Helios-Rocket/power-management/common/mtj-889x1-model.step

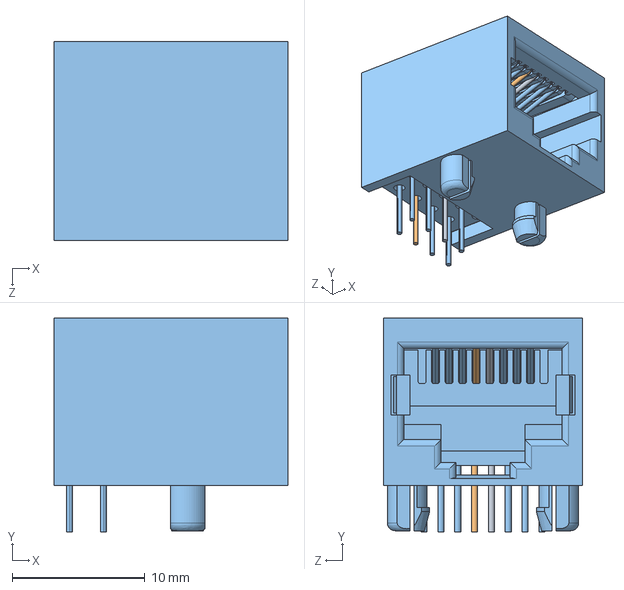
[picture p1: CAD file, 2026-10-05]
common/mtj-889x1-model.step
17.6 x 16.1 x 15.0 mm
