Helios-Rocket/power-management/life-bms/helios-bms-life.step

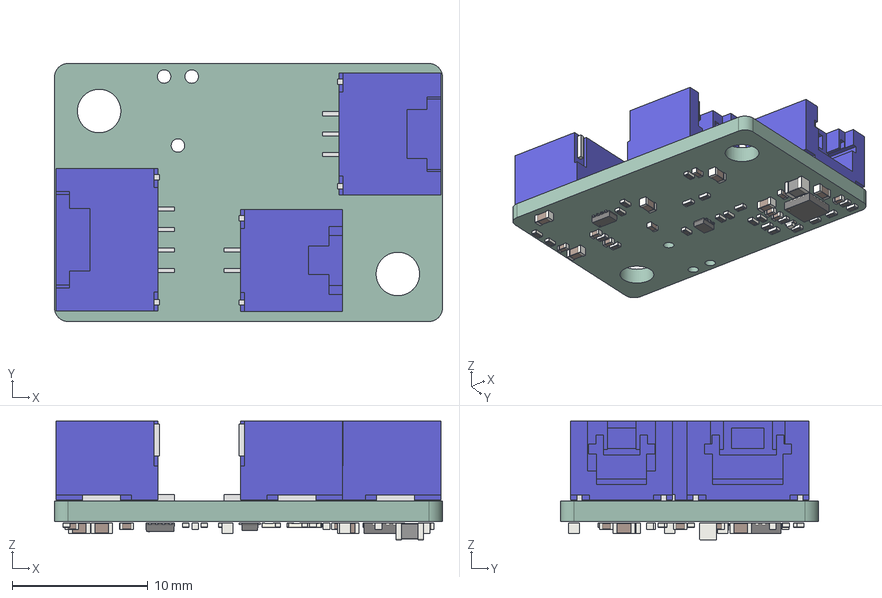
[picture p2: CAD file, 2026-09-29]
life-bms/helios-bms-life.step
28.6 x 19.0 x 8.73 mm
SM04B-ZESS
SM02B-ZESS
SM03B-ZESS
C_0402_1005Metric x 9
SOT_666
R_0402_1005Metric x 23
C_0603_1608Metric x 6
SOT-583-8
WQFN-16-1EP_3x3mm_P0.5mm_EP1.68x1.68mm
LED_0402_1005Metric
L_0805_2012Metric
helios-bms-life-unsaved-export-g4g4PP_PCB
