Helios-Rocket/power-management/lipo-bms/helios-bms-lipo.step

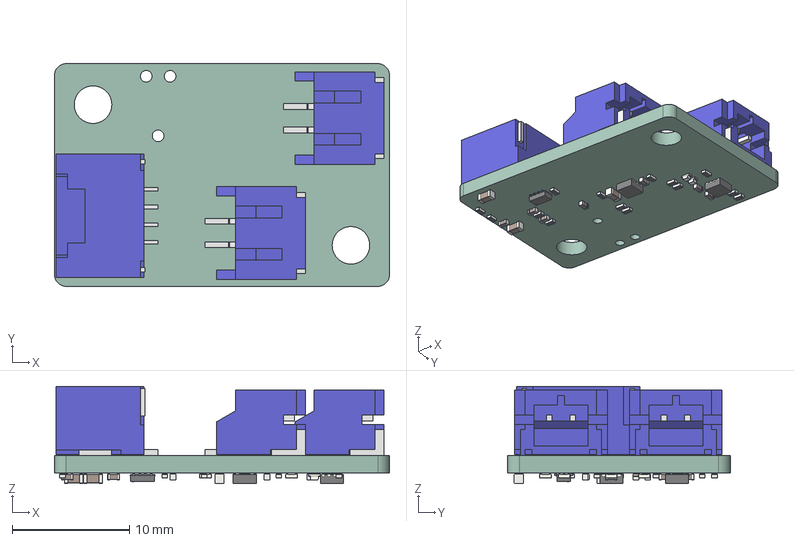
[picture p3: CAD file, 2026-09-29]
lipo-bms/helios-bms-lipo.step
28.6 x 19.0 x 8.30 mm
S2B-PH-SM4 x 2
SM04B-ZESS
C_0402_1005Metric x 7
R_0402_1005Metric x 14
WSON_6_1EP_2x2mm_P065mm_EP1x16mm
SOT-583-8
C_0603_1608Metric x 3
WSON_8_1EP_2x2mm_P05mm_EP09x16mm
LED_0402_1005Metric x 2
helios-bms-lipo-unsaved-export-QEK3tJ_PCB
