Helios-Rocket/power-management/common/2601-1102.igs

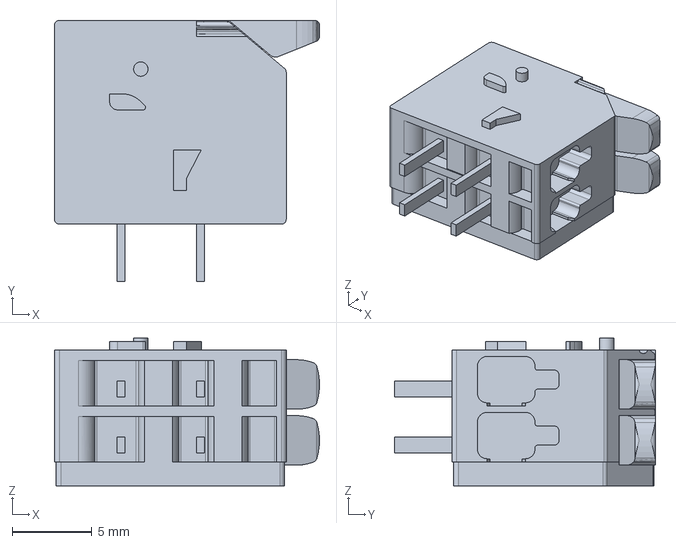
[picture p4: CAD file, 2026-10-05]
common/2601-1102.igs
16.6 x 16.4 x 9.25 mm
