Helios-Rocket/power-management/common/S2B-PH-SM4-TB.STEP

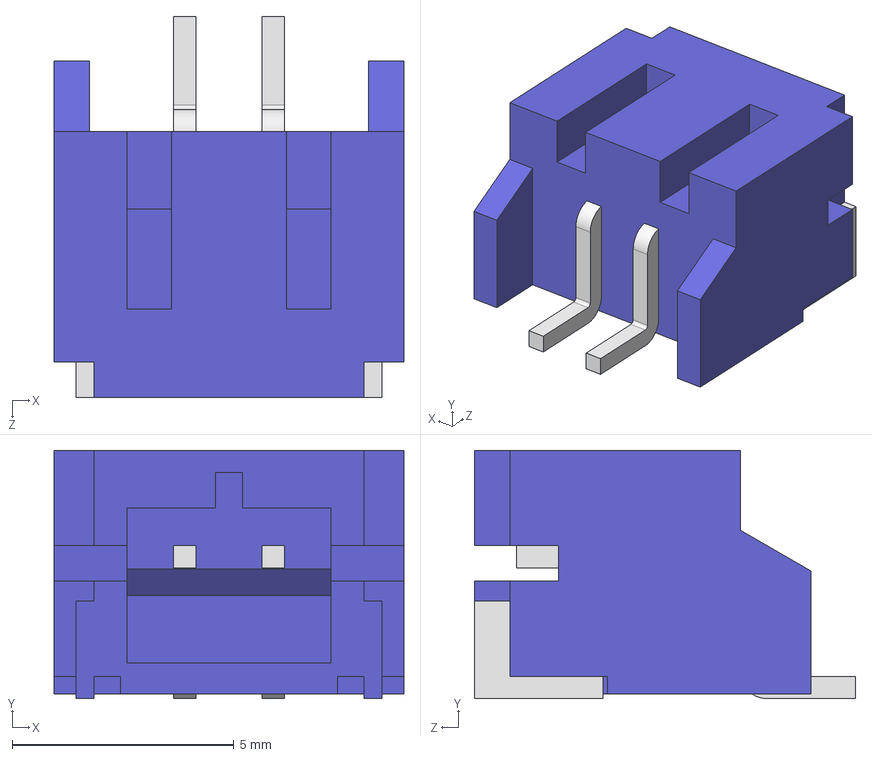
[picture p6: CAD file, 2026-09-29]
common/S2B-PH-SM4-TB.STEP
7.90 x 5.60 x 8.60 mm
