Helios-Rocket/power-management/common/SM02B-ZESS-TB.STEP

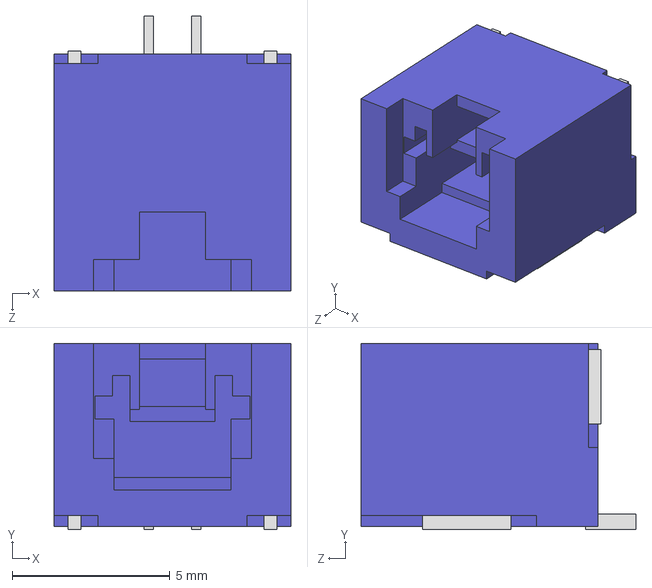
[picture p7: CAD file, 2026-09-29]
common/SM02B-ZESS-TB.STEP
7.50 x 5.90 x 8.70 mm
