Helios-Rocket/power-management/common/SM03B-ZESS-TB.STEP

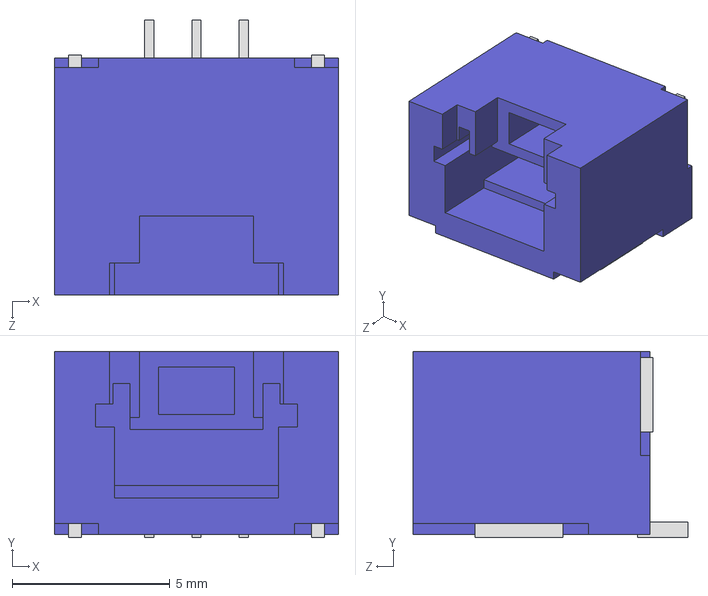
[picture p8: CAD file, 2026-08-21]
common/SM03B-ZESS-TB.STEP
9.00 x 5.90 x 8.70 mm
