Helios-Rocket/power-management/common/UFQFPN20_3x3x0p6.step

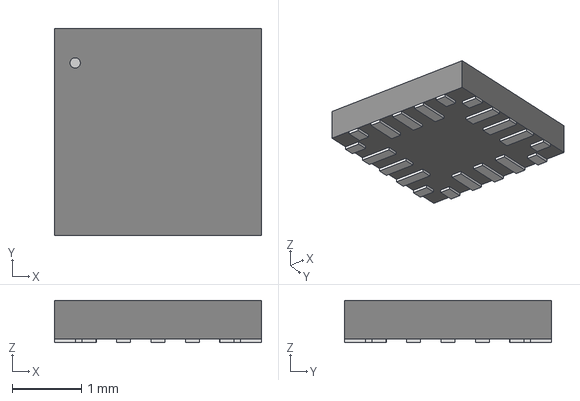
[picture p9: CAD file, 2026-08-21]
common/UFQFPN20_3x3x0p6.step
3.00 x 3.00 x 0.612 mm
