Helios-Rocket/power-management/common/SM04B-ZESS-TB.STEP

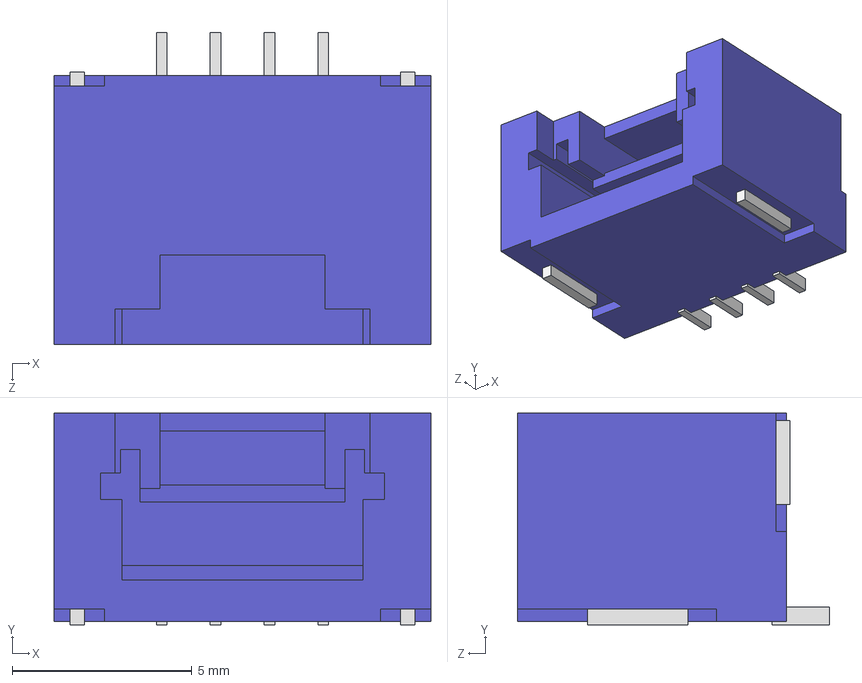
[picture p10: CAD file, 2026-08-21]
common/SM04B-ZESS-TB.STEP
10.5 x 5.90 x 8.70 mm
