Helios-Rocket/power-management/common/UDFN6B.STEP

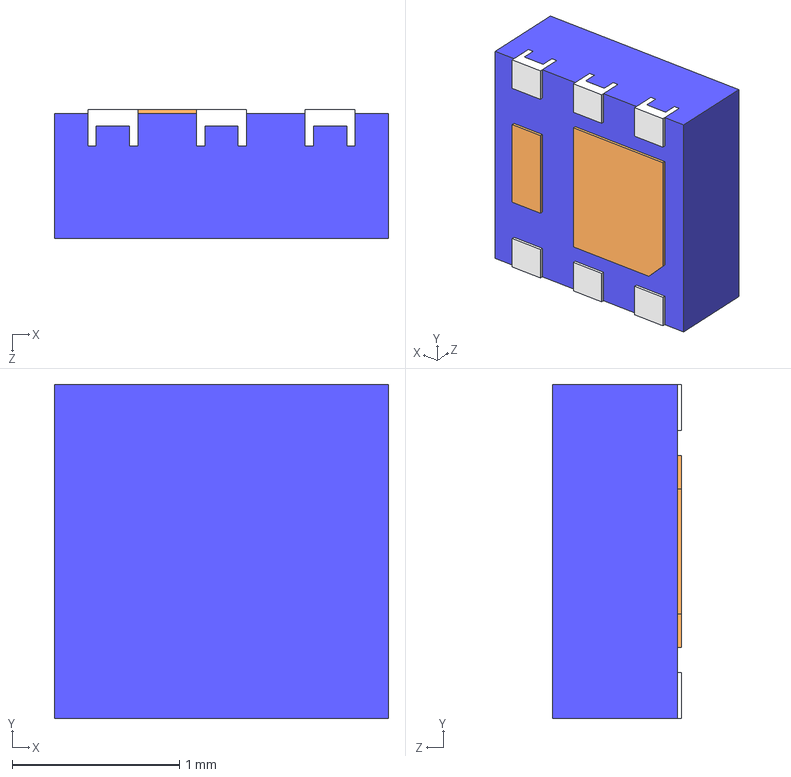
[picture p11: CAD file, 2026-08-18]
common/UDFN6B.STEP
2.00 x 2.00 x 0.775 mm
