Helios-Rocket/power-management/common/TPSM861253RDXR.step

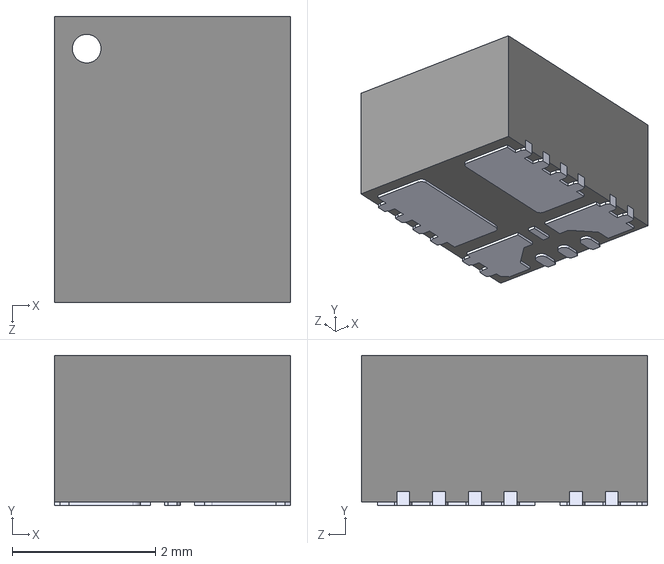
[picture p12: CAD file, 2026-08-14]
common/TPSM861253RDXR.step
3.30 x 2.10 x 4.00 mm
