Helios-Rocket/power-management/common/TPS22811LRPWR.STEP

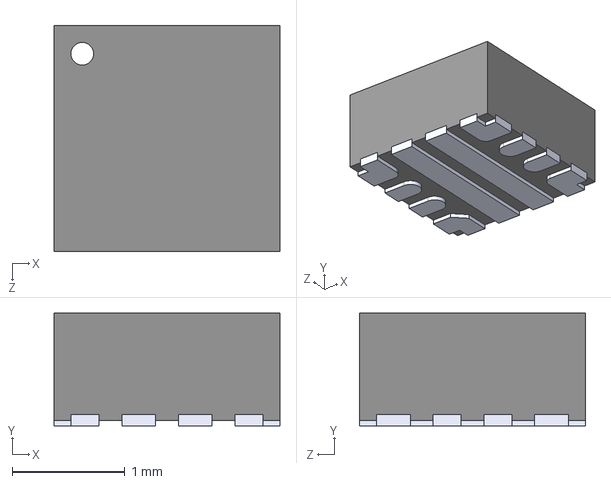
[picture p13: CAD file, 2026-08-07]
common/TPS22811LRPWR.STEP
2.00 x 1.00 x 2.00 mm
