Helios-Rocket/power-management/vehicle-connector/vehicle-connector.kicad_pcb

## KiCad design vehicle-connector/vehicle-connector.kicad_pcb (2026-10-07)

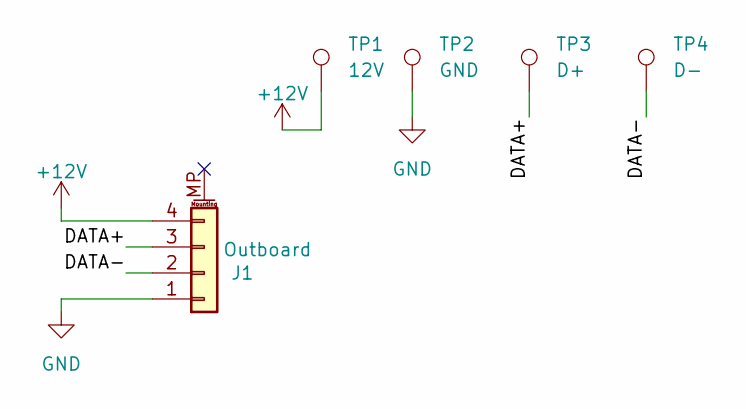
[picture p14: schematic vehicle-connector.kicad_sch]

Parts:
J1: Outboard; JST_ZE_SM04B-ZESS-TB_1x04-1MP_P1.50mm_Horizontal
TP1: 12V; TestPoint_Pad_4.0x4.0mm
TP2: GND; TestPoint_Pad_4.0x4.0mm
TP3: D+; TestPoint_Pad_4.0x4.0mm
TP4: D-; TestPoint_Pad_4.0x4.0mm

Connections:
+12V: J1.4, TP1.1 (1_1)
/DATA+: J1.3, TP3.1 (1_1)
/DATA-: J1.2, TP4.1 (1_1)
GND: J1.1, TP2.1 (1_1)

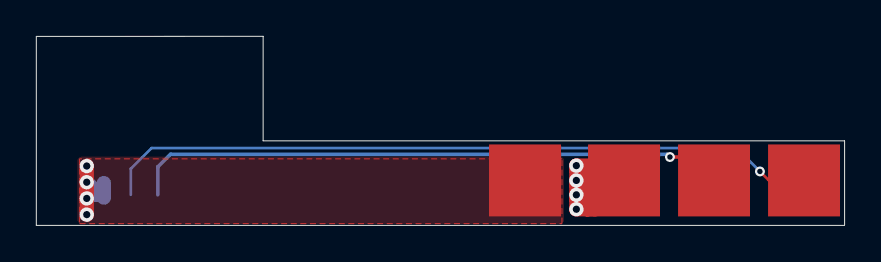
[picture p15: board vehicle-connector.kicad_pcb from above]

Board: 2 copper layers, 44.9 x 10.5 mm, 5 parts (1 on the bottom side), 4 nets.
