Helios-Rocket/power-management/life-bms/helios-bms-life.kicad_pcb

## KiCad design life-bms/helios-bms-life.kicad_pcb (2026-10-07)

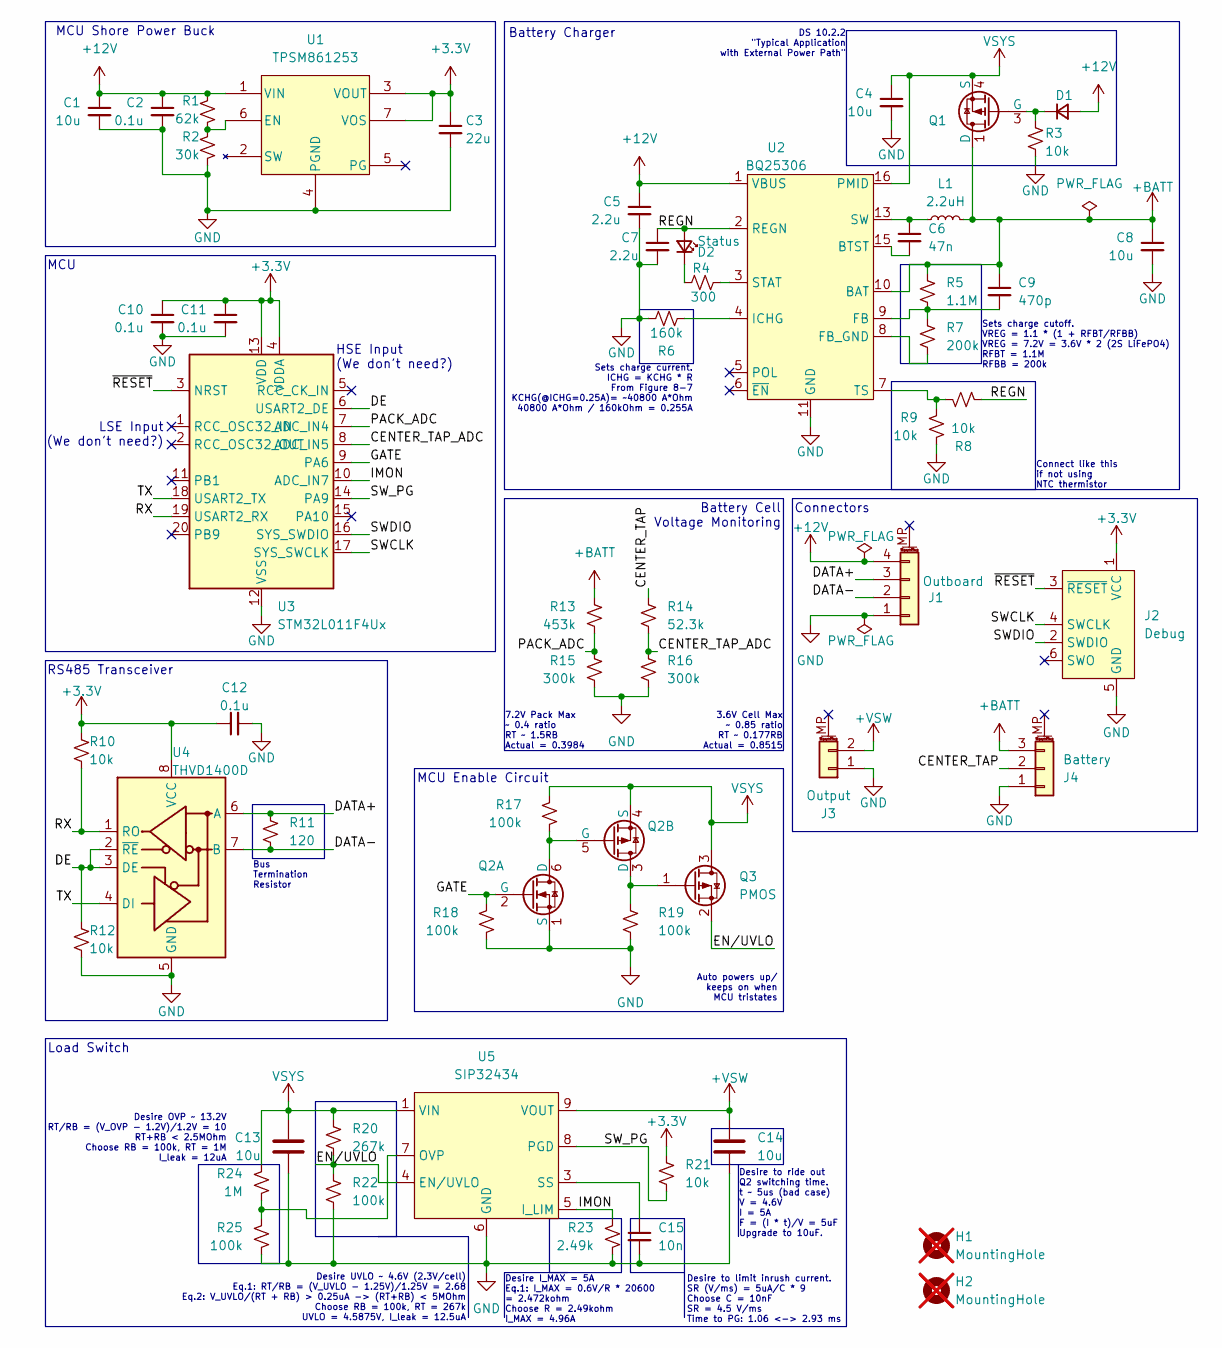
[picture p16: schematic helios-bms-life.kicad_sch]

Parts:
C1, C4, C8, C13, C14: 10u; C_0603_1608Metric
C2, C10, C11, C12: 0.1u; C_0402_1005Metric
C3: 22u; C_0603_1608Metric
C5, C7: 2.2u; C_0402_1005Metric
C6: 47n; C_0402_1005Metric
C9: 470p; C_0402_1005Metric
C15: 10n; C_0402_1005Metric
D1: GSDH3005; D_0402_1005Metric
D2: Status; LED_0402_1005Metric
H1, H2: MountingHole; MountingHole_3.2mm_M3_DIN965; not fitted
J1: Outboard; JST_ZE_SM04B-ZESS-TB_1x04-1MP_P1.50mm_Horizontal
J2: Debug; Tag-Connect_TC2030-IDC-NL_2x03_P1.27mm_Vertical
J3: Output; JST_ZE_SM02B-ZESS-TB_1x02-1MP_P1.50mm_Horizontal
J4: Battery; JST_ZE_SM03B-ZESS-TB_1x03-1MP_P1.50mm_Horizontal
L1: 2.2uH; L_0805_2012Metric
Q1: SSM6J507NU; SOT-1220_UDFN6B_TOS-L
Q2: Q_Dual_NMOS_PMOS_S1G1D2S2G2D1; SOT-666
Q3: PMOS; SOT-723
R1: 62k; R_0402_1005Metric
R2: 30k; R_0402_1005Metric
R3, R8, R9, R10, R12, R21: 10k; R_0402_1005Metric
R4: 300; R_0402_1005Metric
R5: 1.1M; R_0402_1005Metric
R6: 160k; R_0402_1005Metric
R7: 200k; R_0402_1005Metric
R11: 120; R_0402_1005Metric
R13: 453k; R_0402_1005Metric
R14: 52.3k; R_0402_1005Metric
R15, R16: 300k; R_0402_1005Metric
R17, R18, R19, R22, R25: 100k; R_0402_1005Metric
R20: 267k; R_0402_1005Metric
R23: 2.49k; R_0402_1005Metric
R24: 1M; R_0402_1005Metric
U1: TPSM861253; Texas-QFN-FCMOD-7_4x3.3mm
U2: BQ25306; WQFN-16-1EP_3x3mm_P0.5mm_EP1.68x1.68mm_ThermalVias
U3: STM32L011F4Ux; ST_UFQFPN-20_3x3mm_P0.5mm
U4: THVD1400D; SOT-583-8
U5: SIP32434; Maxim_TDFN-10-1EP_3x3mm_P0.5mm_EP1.58x2.35mm

Connections:
+3.3V: C3.1, C10.1, C11.1, C12.1, J2.1 (VCC), R10.1, R21.2, U1.3 (VOUT), U1.7 (VOS), U3.4 (VDDA), U3.13 (VDD), U4.8 (VCC)
+12V: C1.1, C2.1, C5.1, D1.2 (A), J1.4, R1.1, U1.1 (VIN), U2.1 (VBUS)
+BATT: C8.1, C9.1, J4.3, L1.2, Q1.1 (D), Q1.2 (D), Q1.5 (D), Q1.6 (D), Q1.7 (D), R5.1, R13.1, U2.10 (BAT)
+VSW: C14.1, J3.2, U5.9 (VOUT), U5.10 (VOUT)
/CENTER_TAP: J4.2, R14.1
/CENTER_TAP_ADC: R14.2, R16.1, U3.8 (ADC_IN5)
/DATA+: J1.3, R11.1, U4.6 (A)
/DATA-: J1.2, R11.2, U4.7 (B)
/DE: R12.1, U3.6 (USART2_DE), U4.2 (~RE), U4.3 (DE)
/EN/UVLO: Q3.2 (S), R20.1, R22.2, U5.4 (EN/UVLO)
/GATE: Q2.2 (G), R18.1, U3.9 (PA6)
/IMON: R23.2, U3.10 (ADC_IN7), U5.5 (I_LIM)
/PACK_ADC: R13.2, R15.1, U3.7 (ADC_IN4)
/REGN: C7.1, D2.2 (A), R8.2, U2.2 (REGN)
/RX: R10.2, U3.19 (USART2_RX), U4.1 (RO)
/SWCLK: J2.4 (SWCLK), U3.17 (SYS_SWCLK)
/SWDIO: J2.2 (SWDIO), U3.16 (SYS_SWDIO)
/SW_PG: R21.1, U3.14 (PA9), U5.8 (PGD)
/TX: U3.18 (USART2_TX), U4.4 (DI)
/~RESET: J2.3 (~RESET), U3.3 (NRST)
GND: C1.2, C2.2, C3.2, C4.2, C5.2, C7.2, C8.2, C10.2, C11.2, C12.2, C13.2, C14.2, C15.2, J1.1, J2.5 (GND), J3.1, J4.1, Q2.1 (S), R2.2, R3.2, R6.2, R9.2, R12.2, R15.2, R16.2, R18.2, R19.2, R22.1, R23.1, R25.1, U1.4 (PGND), U2.11 (GND), U2.12 (GND), U2.17 (GND), U3.12 (VSS), U4.5 (GND), U5.6 (GND), U5.11 (GND)
unnamed: C6.1, L1.1, U2.13 (SW), U2.14 (SW)
unnamed: D1.1 (K), Q1.3 (G), R3.1
unnamed: D2.1 (K), R4.1
unnamed: Q2.5 (G), Q2.6 (D), R17.2
unnamed: Q2.3 (D), Q3.1 (G), R19.1
unnamed: R1.2, R2.1, U1.6 (EN)
unnamed: C6.2, U2.15 (BTST)
unnamed: C9.2, R5.2, R7.1, U2.9 (FB)
unnamed: R7.2, U2.8 (FB_GND)
unnamed: R6.1, U2.4 (ICHG)
unnamed: R4.2, U2.3 (STAT)
unnamed: R8.1, R9.1, U2.7 (TS)
unnamed: R24.1, R25.2, U5.7 (OVP)
unnamed: C15.1, U5.3 (SS)
VSYS: C4.1, C13.1, Q1.4 (S), Q1.8 (S), Q2.4 (S), Q3.3 (D), R17.1, R20.2, R24.2, U2.16 (PMID), U5.1 (VIN), U5.2 (VIN)

Notes on the sheet:
LSE Input (We don't need?)
MCU Shore Power Buck
Load Switch
DS 10.2.2 "Typical Application with External Power Path"
Sets charge cutoff. VREG = 1.1 * (1 + RFBT/RFBB) VREG = 7.2V = 3.6V * 2 (2S LiFePO4) RFBT = 1.1M RFBB = 200k
Sets charge current. ICHG = KCHG * R From Figure 8-7 KCHG(@ICHG=0.25A)= ~40800 A*Ohm 40800 A*Ohm / 160kOhm = 0.255A
Connect like this if not using NTC thermistor
HSE Input (We don't need?)
RS485 Transceiver
MCU Enable Circuit
Auto powers up/ keeps on when MCU tristates
MCU
Bus Termination Resistor
Desire to limit inrush current. SR (V/ms) = 5uA/C * 9 Choose C = 10nF SR = 4.5 V/ms Time to PG: 1.06 <-> 2.93 ms
Desire UVLO ~ 4.6V (2.3V/cell) Eq.1: RT/RB = (V_UVLO - 1.25V)/1.25V = 2.68 Eq.2: V_UVLO/(RT + RB) > 0.25uA -> (RT+RB) < 5MOhm Choose RB = 100k, RT = 267k UVLO = 4.5875V, I_leak = 12.5uA
Battery Cell Voltage Monitoring
7.2V Pack Max ~ 0.4 ratio RT ~ 1.5RB Actual = 0.3984
Battery Charger
Desire I_MAX = 5A Eq.1: I_MAX = 0.6V/R * 20600 = 2.472kohm Choose R = 2.49kohm I_MAX = 4.96A
Desire OVP ~ 13.2V RT/RB = (V_OVP - 1.2V)/1.2V = 10 RT+RB < 2.5MOhm Choose RB = 100k, RT = 1M I_leak = 12uA
Desire to ride out Q2 switching time. t ~ 5us (bad case) V = 4.6V I = 5A F = (I * t)/V = 5uF Upgrade to 10uF.
3.6V Cell Max ~ 0.85 ratio RT ~ 0.177RB Actual = 0.8515
Connectors

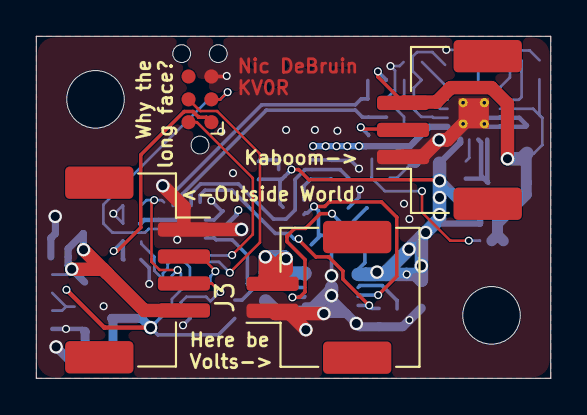
[picture p17: board helios-bms-life.kicad_pcb from above]

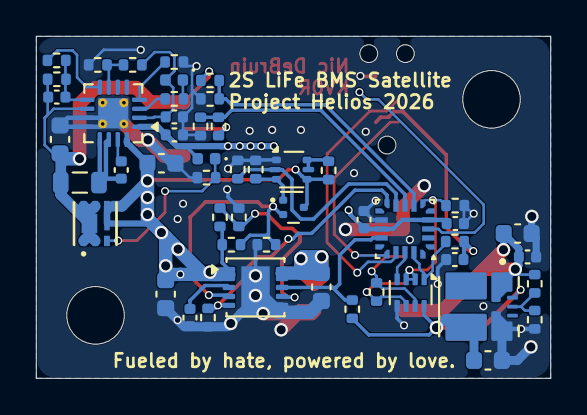
[picture p18: board helios-bms-life.kicad_pcb from below]

Board: 4 copper layers, 28.6 x 19.0 mm, 57 parts (51 on the bottom side), 36 nets.
