Helios-Rocket/power-management/umbilical-controller/umbilical-controller.kicad_pcb

## KiCad design umbilical-controller/umbilical-controller.kicad_pcb (2026-10-07)

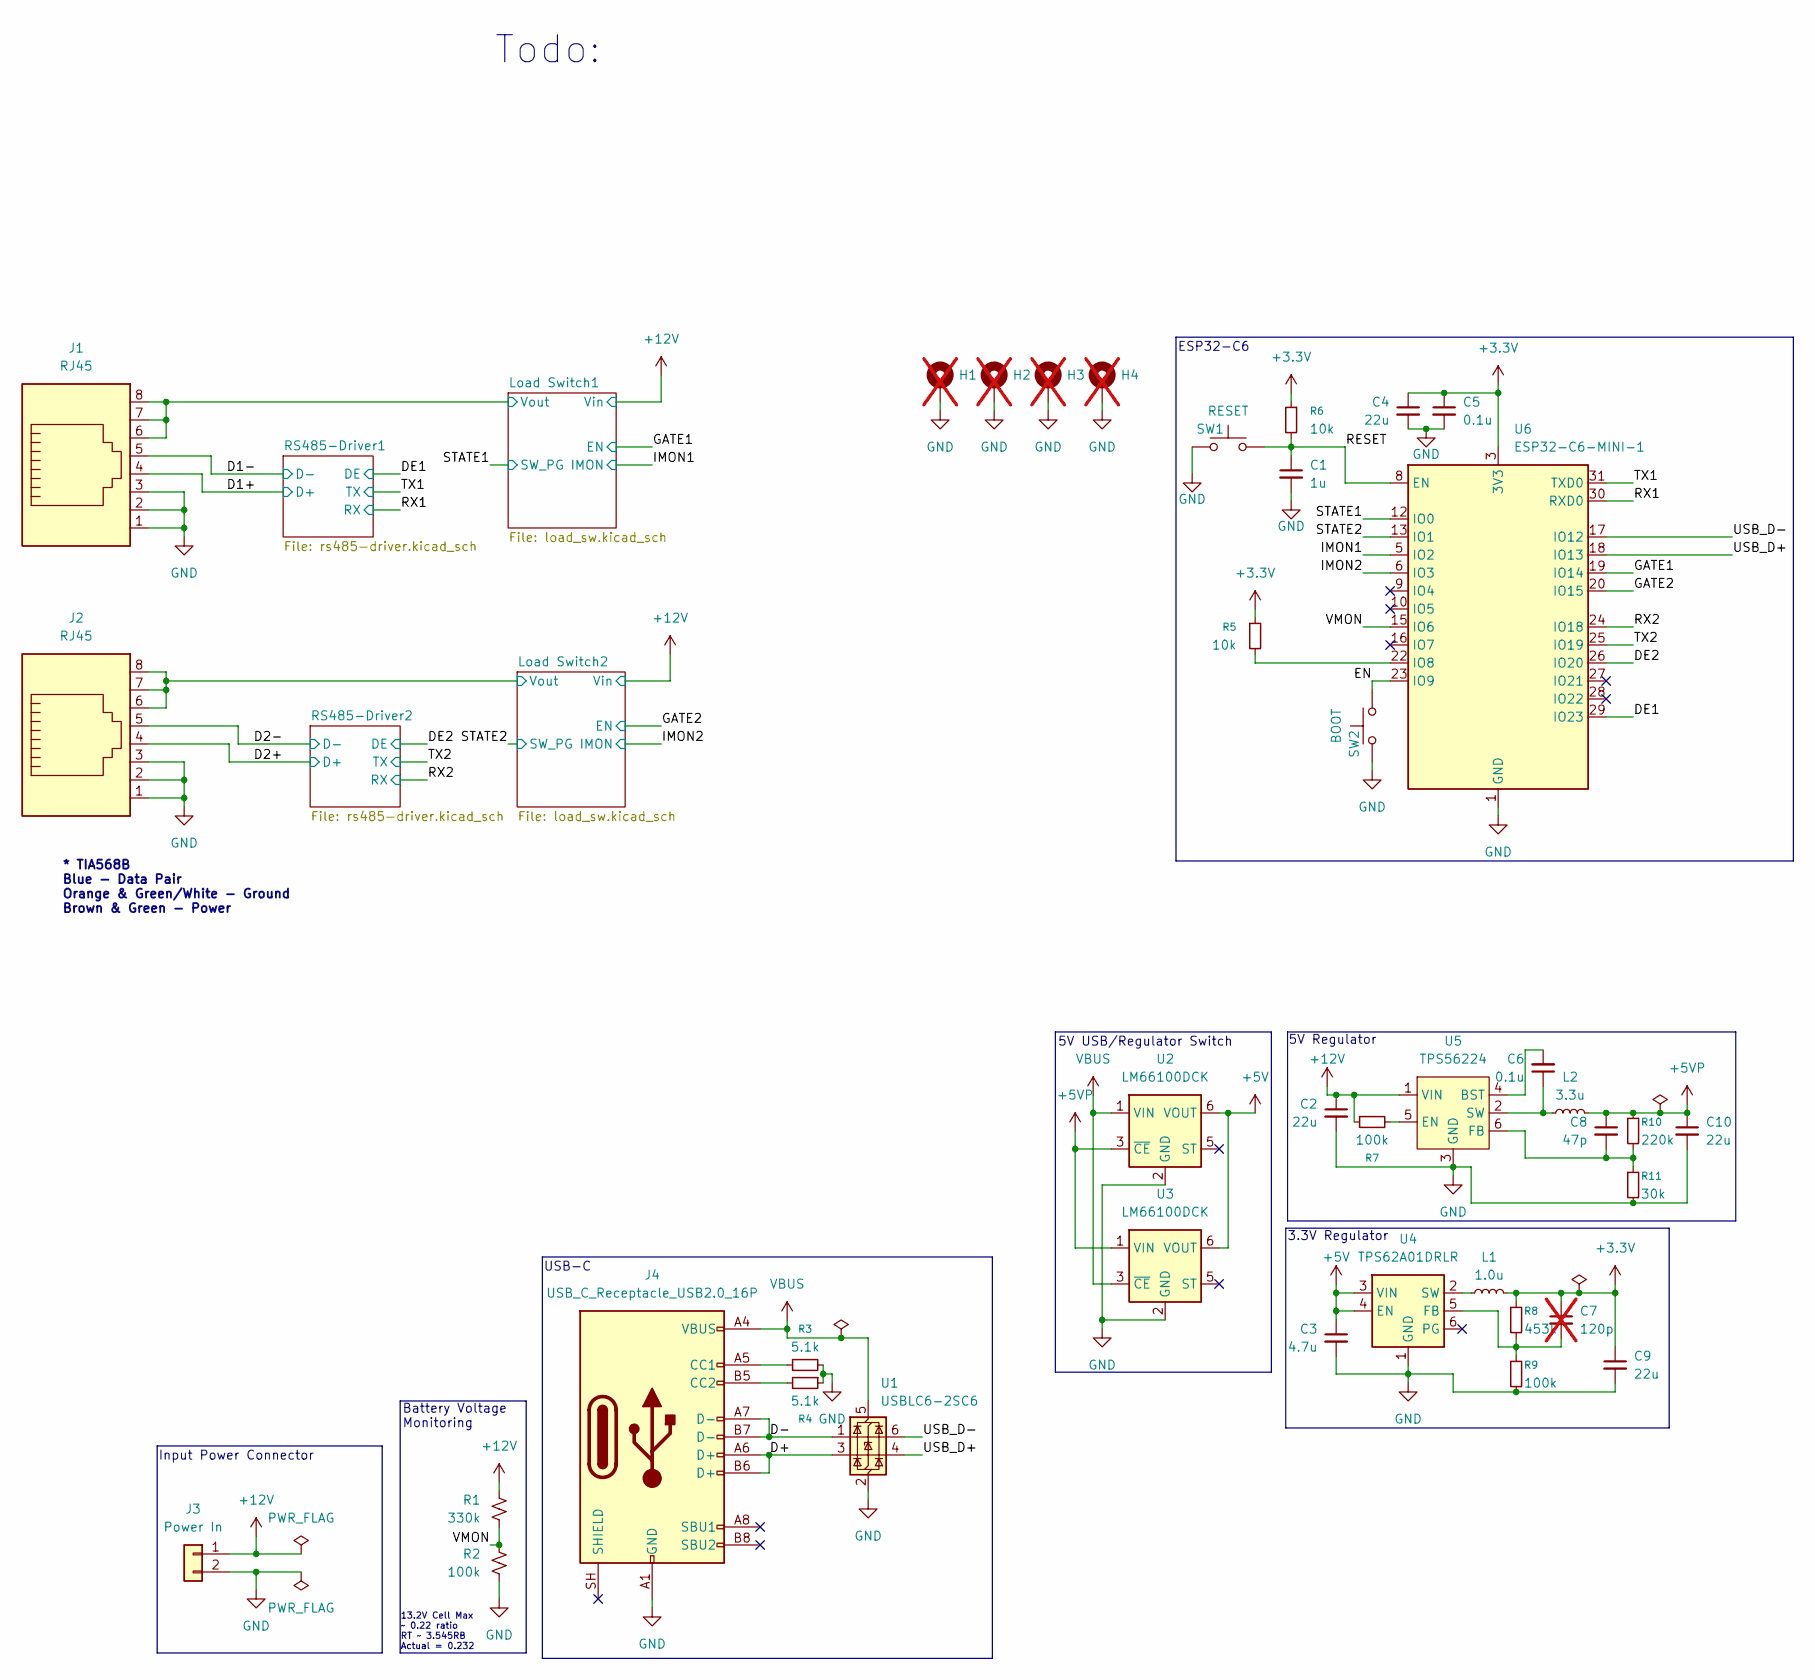
[picture p19: schematic umbilical-controller.kicad_sch]

Parts:
C1: 1u; C_0603_1608Metric
C2: 22u; C_0805_2012Metric
C3: 4.7u; C_0603_1608Metric
C4, C9, C10: 22u; C_0603_1608Metric
C5, C6: 0.1u; C_0603_1608Metric
C7: 120p; C_0603_1608Metric; not fitted
C8: 47p; C_0603_1608Metric
H1, H2, H3, H4: MountingHole_Pad_MP; MountingHole_4.3mm_M4_ISO7380_Pad_TopBottom; not fitted
J1, J2: RJ45; RJ45_Amphenol_54602-x08_Horizontal
J3: Power In; TerminalBlock_WAGO_2601-1102_1x02_P3.50mm_Horizontal
J4: USB_C_Receptacle_USB2.0_16P; USB_C_Receptacle_GCT_USB4105-xx-A_16P_TopMnt_Horizontal
L1: 1.0u; L_1008_2520Metric
L2: 3.3u; L_1008_2520Metric
R1: 330k; R_0603_1608Metric
R2, R7, R9: 100k; R_0603_1608Metric
R3, R4: 5.1k; R_0603_1608Metric
R5, R6: 10k; R_0603_1608Metric
R8: 453k; R_0603_1608Metric
R10: 220k; R_0603_1608Metric
R11: 30k; R_0603_1608Metric
SW1: RESET; SW_Push_1P1T_NO_E-Switch_TL3301NxxxxxG
SW2: BOOT; SW_Push_1P1T_NO_E-Switch_TL3301NxxxxxG
U1: USBLC6-2SC6; SOT-23-6
U2, U3: LM66100DCK; SOT-363_SC-70-6
U4: TPS62A01DRLR; SOT-563
U5: TPS56224; SOT-563
U6: ESP32-C6-MINI-1

Connections:
+3.3V: C4.1, C5.1, C7.1, C9.1, L1.2, R5.1, R6.1, R8.1, U6.3 (3V3); also elsewhere on the board
+5V: C3.1, U2.6 (VOUT), U3.6 (VOUT), U4.3 (VIN), U4.4 (EN)
+5VP: C8.1, C10.1, L2.2, R10.1, U2.3 (~CE), U3.1 (VIN)
+12V: C2.1, J3.1, R1.1, R7.1, U5.1 (VIN); also elsewhere on the board
/D1+: J1.4; also elsewhere on the board
/D1-: J1.5; also elsewhere on the board
/D2+: J2.4; also elsewhere on the board
/D2-: J2.5; also elsewhere on the board
/D+: J4.A6 (D+), J4.B6 (D+), U1.3 (I/O2)
/D-: J4.A7 (D-), J4.B7 (D-), U1.1 (I/O1)
/DE1: U6.29 (IO23); also elsewhere on the board
/DE2: U6.26 (IO20); also elsewhere on the board
/EN: SW2.1, U6.23 (IO9)
/GATE1: U6.19 (IO14); also elsewhere on the board
/GATE2: U6.20 (IO15); also elsewhere on the board
/IMON1: U6.5 (IO2); also elsewhere on the board
/IMON2: U6.6 (IO3); also elsewhere on the board
/Load Switch1/Vout: J1.6, J1.7, J1.8; also elsewhere on the board
/Load Switch2/Vout: J2.6, J2.7, J2.8; also elsewhere on the board
/RESET: C1.1, R6.2, SW1.1, U6.8 (EN)
/RX1: U6.30 (RXD0); also elsewhere on the board
/RX2: U6.24 (IO18); also elsewhere on the board
/STATE1: U6.12 (IO0); also elsewhere on the board
/STATE2: U6.13 (IO1); also elsewhere on the board
/TX1: U6.31 (TXD0); also elsewhere on the board
/TX2: U6.25 (IO19); also elsewhere on the board
/USB_D+: U1.4 (I/O2), U6.18 (IO13)
/USB_D-: U1.6 (I/O1), U6.17 (IO12)
/VMON: R1.2, R2.1, U6.15 (IO6)
GND: C1.2, C2.2, C3.2, C4.2, C5.2, C9.2, C10.2, H1.1 (1_1), H2.1 (1_1), H3.1 (1_1), H4.1 (1_1), J1.1, J1.2, J1.3, J2.1, J2.2, J2.3, J3.2, J4.A1 (GND), J4.A12 (GND), J4.B1 (GND), J4.B12 (GND), R2.2, R3.2, R4.1, R9.2, R11.2, SW1.2, SW2.2, U1.2 (GND), U2.2 (GND), U3.2 (GND), U4.1 (GND), U5.3 (GND), U6.1 (GND), U6.2 (GND), U6.11 (GND), U6.14 (GND), U6.36 (GND), U6.37 (GND), U6.38 (GND), U6.39 (GND), U6.40 (GND), U6.41 (GND), U6.42 (GND), U6.43 (GND), U6.44 (GND), U6.45 (GND), U6.46 (GND), U6.47 (GND), U6.48 (GND), U6.49 (GND), U6.50 (GND), U6.51 (GND), U6.52 (GND), U6.53 (GND); also elsewhere on the board
unnamed: J4.A5 (CC1), R3.1
unnamed: J4.B5 (CC2), R4.2
unnamed: C7.2, R8.2, R9.1, U4.5 (FB)
unnamed: L1.1, U4.2 (SW)
unnamed: C6.2, U5.4 (BST)
unnamed: R7.2, U5.5 (EN)
unnamed: C8.2, R10.2, R11.1, U5.6 (FB)
unnamed: C6.1, L2.1, U5.2 (SW)
unnamed: R5.2, U6.22 (IO8)
VBUS: J4.A4 (VBUS), J4.A9 (VBUS), J4.B4 (VBUS), J4.B9 (VBUS), U1.5 (VBUS), U2.1 (VIN), U3.3 (~CE)

Notes on the sheet:
Todo:
5V Regulator
3.3V Regulator
Input Power Connector
Battery Voltage Monitoring
USB-C
13.2V Cell Max ~ 0.22 ratio RT ~ 3.545RB Actual = 0.232
ESP32-C6
5V USB/Regulator Switch
* TIA568B Blue - Data Pair Orange & Green/White - Ground Brown & Green - Power

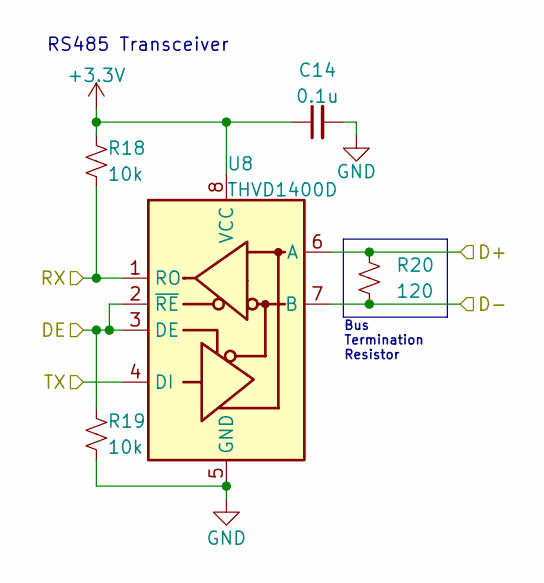
[picture p20: schematic rs485-driver.kicad_sch]

Parts:
C14: 0.1u; C_0603_1608Metric
R18, R19: 10k; R_0603_1608Metric
R20: 120; R_0603_1608Metric
U8: THVD1400D; SOT-583-8

Connections:
+3.3V: C14.1, R18.1, U8.8 (VCC); also elsewhere on the board
/D1+: R20.1, U8.6 (A); also elsewhere on the board
/D1-: R20.2, U8.7 (B); also elsewhere on the board
/DE1: R19.1, U8.2 (~RE), U8.3 (DE); also elsewhere on the board
/RX1: R18.2, U8.1 (RO); also elsewhere on the board
/TX1: U8.4 (DI); also elsewhere on the board
GND: C14.2, R19.2, U8.5 (GND); also elsewhere on the board

Parts of its further copies:
C15: 0.1u; C_0603_1608Metric
R21, R22: 10k; R_0603_1608Metric
R23: 120; R_0603_1608Metric
U9: THVD1400D; SOT-583-8

Connections of its further copies:
+3.3V: C15.1, R21.1, U9.8 (VCC); also elsewhere on the board
/D2+: R23.1, U9.6 (A); also elsewhere on the board
/D2-: R23.2, U9.7 (B); also elsewhere on the board
/DE2: R22.1, U9.2 (~RE), U9.3 (DE); also elsewhere on the board
/RX2: R21.2, U9.1 (RO); also elsewhere on the board
/TX2: U9.4 (DI); also elsewhere on the board
GND: C15.2, R22.2, U9.5 (GND); also elsewhere on the board

Notes on the sheet:
RS485 Transceiver
Bus Termination Resistor

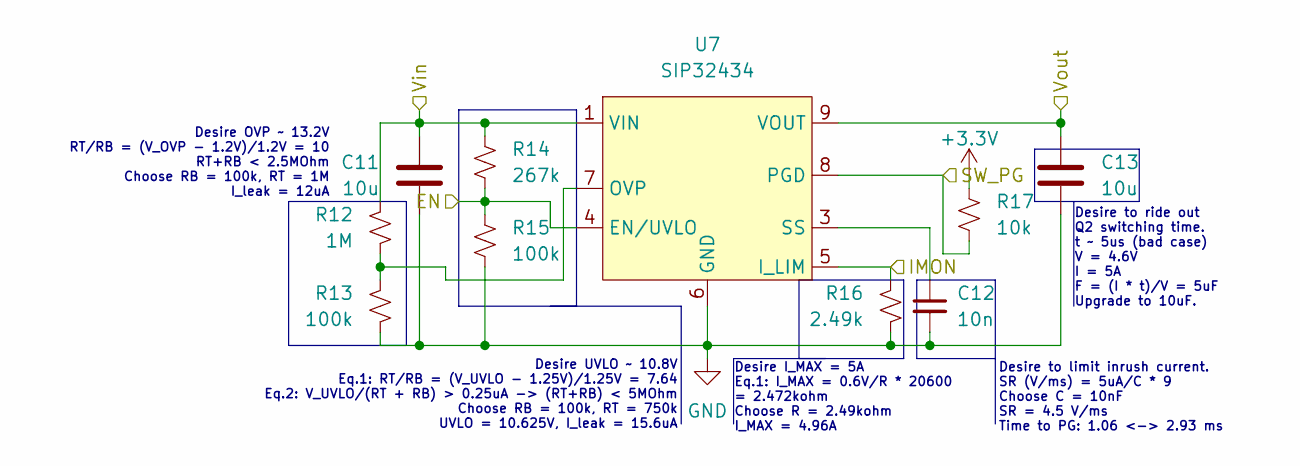
[picture p21: schematic load_sw.kicad_sch]

Parts:
C11, C13: 10u; C_0603_1608Metric
C12: 10n; C_0603_1608Metric
R12: 1M; R_0603_1608Metric
R13, R15: 100k; R_0603_1608Metric
R14: 267k; R_0603_1608Metric
R16: 2.49k; R_0603_1608Metric
R17: 10k; R_0603_1608Metric
U7: SIP32434; Maxim_TDFN-10-1EP_3x3mm_P0.5mm_EP1.58x2.35mm

Connections:
+3.3V: R17.2; also elsewhere on the board
+12V: C11.1, R12.2, R14.2, U7.1 (VIN), U7.2 (VIN); also elsewhere on the board
/GATE2: R14.1, R15.2, U7.4 (EN/UVLO); also elsewhere on the board
/IMON2: R16.2, U7.5 (I_LIM); also elsewhere on the board
/Load Switch2/Vout: C13.1, U7.9 (VOUT), U7.10 (VOUT); also elsewhere on the board
/STATE2: R17.1, U7.8 (PGD); also elsewhere on the board
GND: C11.2, C12.2, C13.2, R13.1, R15.1, R16.1, U7.6 (GND), U7.11 (GND); also elsewhere on the board
unnamed: R12.1, R13.2, U7.7 (OVP)
unnamed: C12.1, U7.3 (SS)

Parts of its further copies:
C16, C18: 10u; C_0603_1608Metric
C17: 10n; C_0603_1608Metric
R24: 1M; R_0603_1608Metric
R25, R27: 100k; R_0603_1608Metric
R26: 267k; R_0603_1608Metric
R28: 2.49k; R_0603_1608Metric
R29: 10k; R_0603_1608Metric
U10: SIP32434; Maxim_TDFN-10-1EP_3x3mm_P0.5mm_EP1.58x2.35mm

Connections of its further copies:
+3.3V: R29.2; also elsewhere on the board
+12V: C16.1, R24.2, R26.2, U10.1 (VIN), U10.2 (VIN); also elsewhere on the board
/GATE1: R26.1, R27.2, U10.4 (EN/UVLO); also elsewhere on the board
/IMON1: R28.2, U10.5 (I_LIM); also elsewhere on the board
/Load Switch1/Vout: C18.1, U10.9 (VOUT), U10.10 (VOUT); also elsewhere on the board
/STATE1: R29.1, U10.8 (PGD); also elsewhere on the board
GND: C16.2, C17.2, C18.2, R25.1, R27.1, R28.1, U10.6 (GND), U10.11 (GND); also elsewhere on the board
unnamed: R24.1, R25.2, U10.7 (OVP)
unnamed: C17.1, U10.3 (SS)

Notes on the sheet:
Desire to limit inrush current. SR (V/ms) = 5uA/C * 9 Choose C = 10nF SR = 4.5 V/ms Time to PG: 1.06 <-> 2.93 ms
Desire OVP ~ 13.2V RT/RB = (V_OVP - 1.2V)/1.2V = 10 RT+RB < 2.5MOhm Choose RB = 100k, RT = 1M I_leak = 12uA
Desire I_MAX = 5A Eq.1: I_MAX = 0.6V/R * 20600 = 2.472kohm Choose R = 2.49kohm I_MAX = 4.96A
Desire to ride out Q2 switching time. t ~ 5us (bad case) V = 4.6V I = 5A F = (I * t)/V = 5uF Upgrade to 10uF.
Desire UVLO ~ 10.8V Eq.1: RT/RB = (V_UVLO - 1.25V)/1.25V = 7.64 Eq.2: V_UVLO/(RT + RB) > 0.25uA -> (RT+RB) < 5MOhm Choose RB = 100k, RT = 750k UVLO = 10.625V, I_leak = 15.6uA

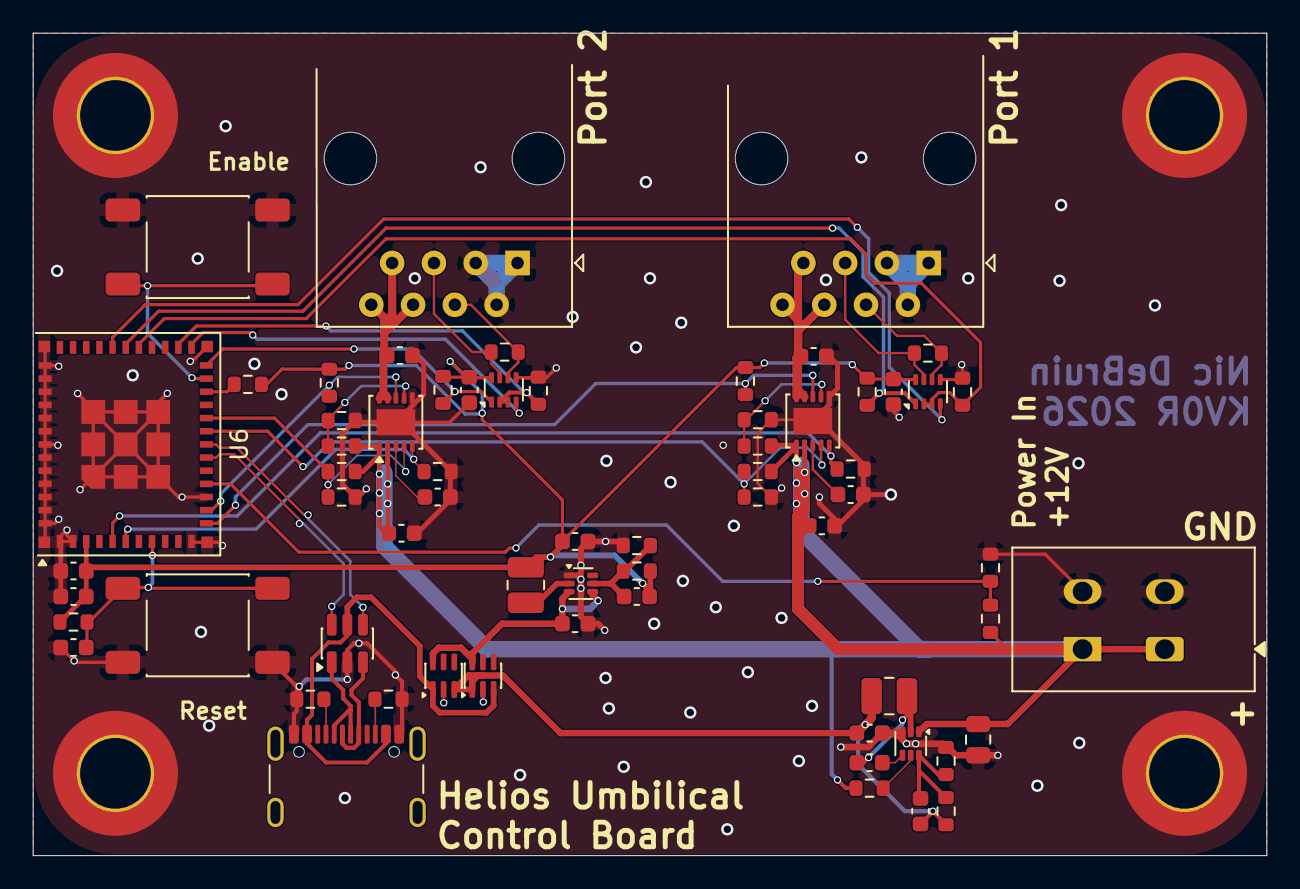
[picture p22: board umbilical-controller.kicad_pcb from above]

Board: 2 copper layers, 75.0 x 50.0 mm, 69 parts (0 on the bottom side), 44 nets.
