Helios-Rocket/power-management/lipo-bms/helios-bms-lipo.kicad_pcb

## KiCad design lipo-bms/helios-bms-lipo.kicad_pcb (2026-09-29)

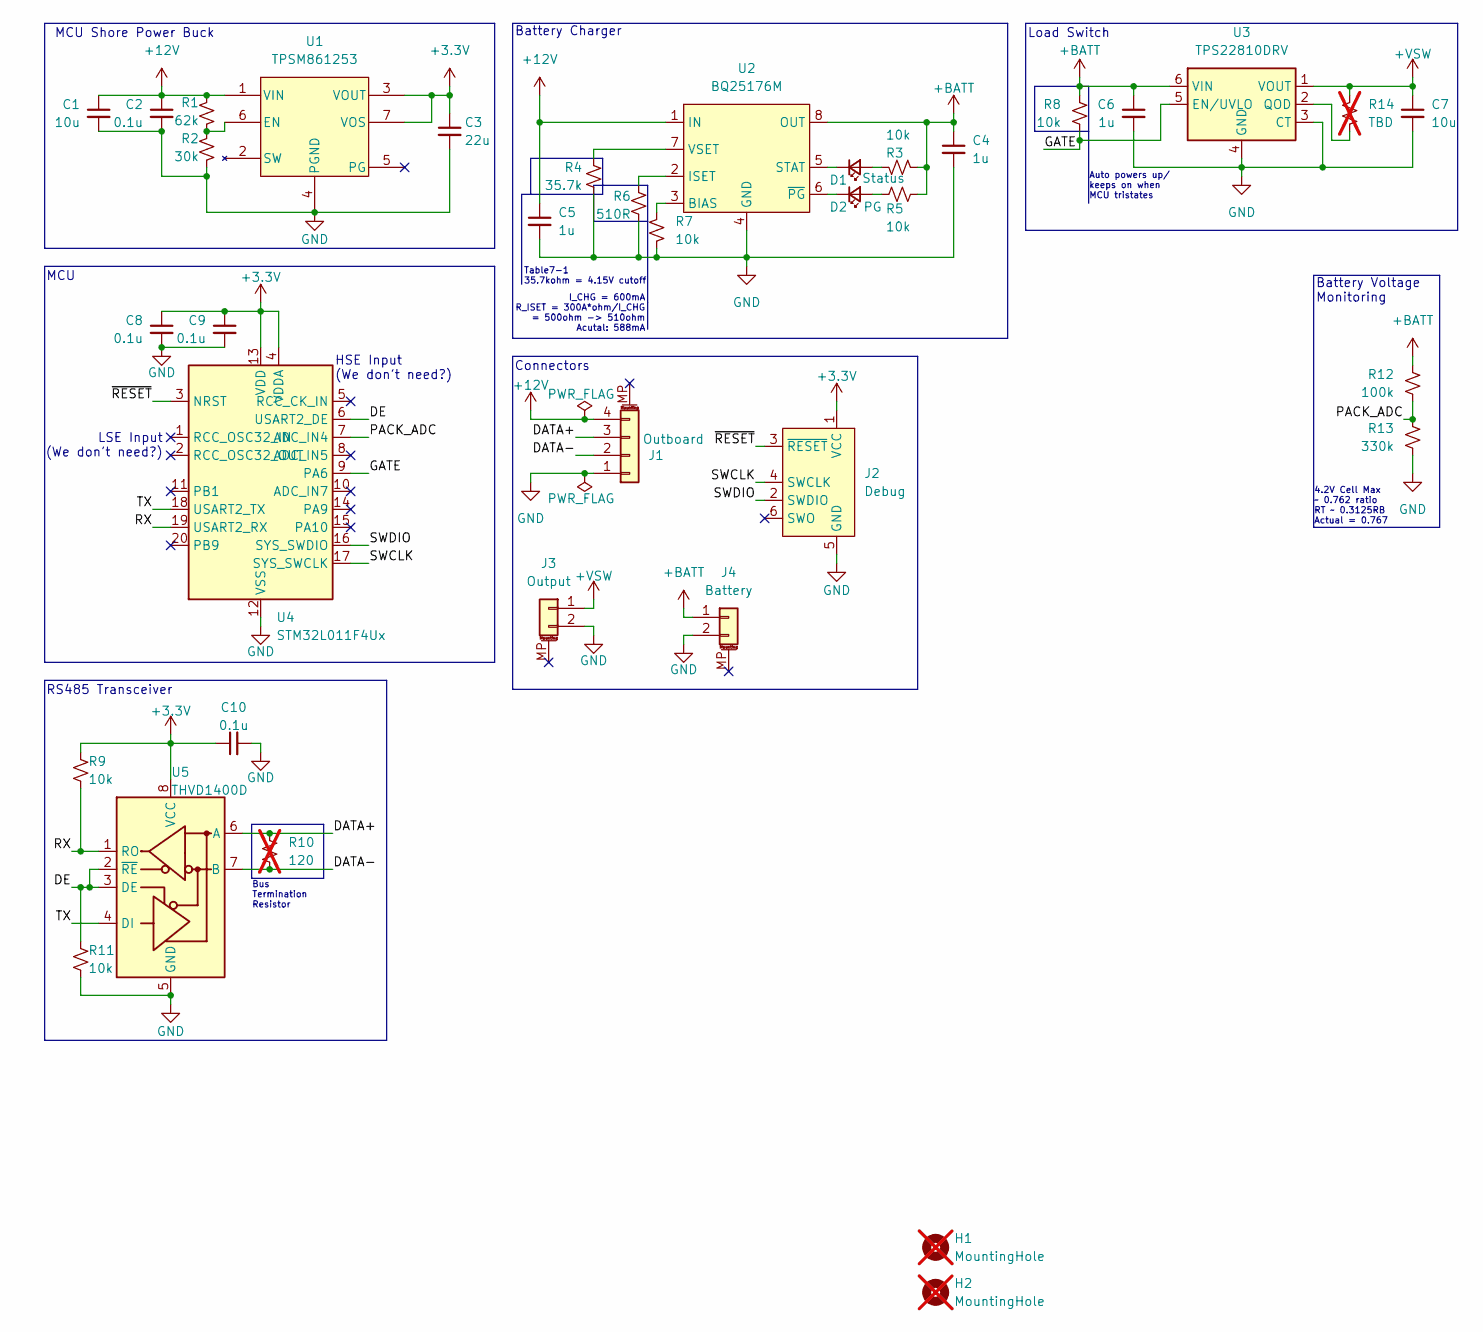
[picture p23: schematic helios-bms-lipo.kicad_sch]

Parts:
C1, C7: 10u; C_0603_1608Metric
C2, C8, C9, C10: 0.1u; C_0402_1005Metric
C3: 22u; C_0603_1608Metric
C4, C5, C6: 1u; C_0402_1005Metric
D1: Status; LED_0402_1005Metric
D2: PG; LED_0402_1005Metric
H1, H2: MountingHole; MountingHole_3.2mm_M3_DIN965; not fitted
J1: Outboard; JST_ZE_SM04B-ZESS-TB_1x04-1MP_P1.50mm_Horizontal
J2: Debug; Tag-Connect_TC2030-IDC-NL_2x03_P1.27mm_Vertical
J3: Output; JST_PH_S2B-PH-SM4-TB_1x02-1MP_P2.00mm_Horizontal
J4: Battery; JST_PH_S2B-PH-SM4-TB_1x02-1MP_P2.00mm_Horizontal
R1: 62k; R_0402_1005Metric
R2: 30k; R_0402_1005Metric
R3, R5, R7, R8, R9, R11: 10k; R_0402_1005Metric
R4: 35.7k; R_0402_1005Metric
R6: 510R; R_0402_1005Metric
R10: 120; R_0402_1005Metric; not fitted
R12: 100k; R_0402_1005Metric
R13: 330k; R_0402_1005Metric
R14: TBD; R_0402_1005Metric; not fitted
U1: TPSM861253; Texas-QFN-FCMOD-7_4x3.3mm
U2: BQ25176M; WSON-8-1EP_2x2mm_P0.5mm_EP0.9x1.6mm_ThermalVias
U3: TPS22810DRV; WSON-6-1EP_2x2mm_P0.65mm_EP1x1.6mm
U4: STM32L011F4Ux; ST_UFQFPN-20_3x3mm_P0.5mm
U5: THVD1400D; SOT-583-8

Connections:
+3.3V: C3.1, C8.1, C9.1, C10.1, J2.1 (VCC), R9.1, U1.3 (VOUT), U1.7 (VOS), U4.4 (VDDA), U4.13 (VDD), U5.8 (VCC)
+12V: C1.1, C2.1, C5.1, J1.4, R1.1, U1.1 (VIN), U2.1 (IN)
+BATT: C4.1, C6.1, J4.1, R3.2, R5.2, R8.1, R12.1, U2.8 (OUT), U3.6 (VIN)
+VSW: C7.1, J3.1, R14.1, U3.1 (VOUT)
/DATA+: J1.3, R10.1, U5.6 (A)
/DATA-: J1.2, R10.2, U5.7 (B)
/DE: R11.1, U4.6 (USART2_DE), U5.2 (~RE), U5.3 (DE)
/GATE: R8.2, U3.5 (EN/UVLO), U4.9 (PA6)
/PACK_ADC: R12.2, R13.1, U4.7 (ADC_IN4)
/RX: R9.2, U4.19 (USART2_RX), U5.1 (RO)
/SWCLK: J2.4 (SWCLK), U4.17 (SYS_SWCLK)
/SWDIO: J2.2 (SWDIO), U4.16 (SYS_SWDIO)
/TX: U4.18 (USART2_TX), U5.4 (DI)
/~RESET: J2.3 (~RESET), U4.3 (NRST)
GND: C1.2, C2.2, C3.2, C4.2, C5.2, C6.2, C7.2, C8.2, C9.2, C10.2, J1.1, J2.5 (GND), J3.2, J4.2, R2.2, R4.2, R6.2, R7.2, R11.2, R13.2, U1.4 (PGND), U2.4 (GND), U2.9 (GND), U3.3 (CT), U3.4 (GND), U3.7 (GND), U4.12 (VSS), U5.5 (GND)
unnamed: D1.2 (A), R3.1
unnamed: D1.1 (K), U2.5 (STAT)
unnamed: D2.2 (A), R5.1
unnamed: D2.1 (K), U2.6 (~PG)
unnamed: R1.2, R2.1, U1.6 (EN)
unnamed: R7.1, U2.3 (BIAS)
unnamed: R6.1, U2.2 (ISET)
unnamed: R4.1, U2.7 (VSET)
unnamed: R14.2, U3.2 (QOD)

Notes on the sheet:
LSE Input (We don't need?)
MCU Shore Power Buck
Battery Charger
HSE Input (We don't need?)
RS485 Transceiver
MCU
Bus Termination Resistor
Table7-1 35.7kohm = 4.15V cutoff
Battery Voltage Monitoring
Load Switch
I_CHG = 600mA R_ISET = 300A*ohm/I_CHG = 500ohm -> 510ohm Acutal: 588mA
4.2V Cell Max ~ 0.762 ratio RT ~ 0.3125RB Actual = 0.767
Auto powers up/ keeps on when MCU tristates
Connectors

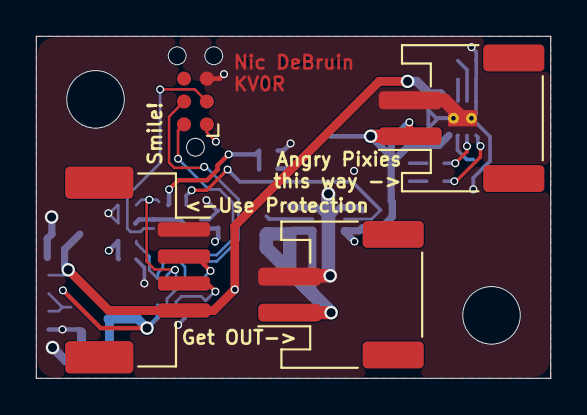
[picture p24: board helios-bms-lipo.kicad_pcb from above]

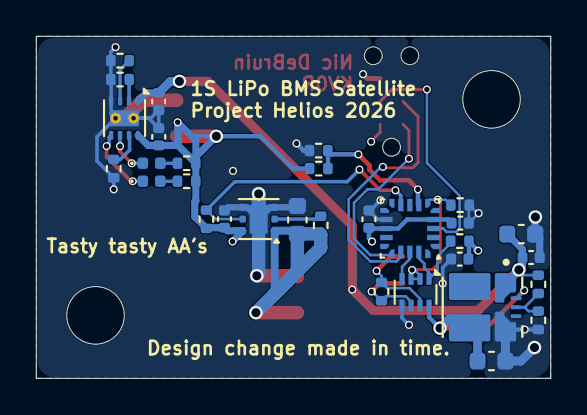
[picture p25: board helios-bms-lipo.kicad_pcb from below]

Board: 4 copper layers, 28.6 x 19.0 mm, 37 parts (31 on the bottom side), 24 nets.
