Helios-Rocket/power-management/bms-board/helios-bms.kicad_pcb

## KiCad design bms-board/helios-bms.kicad_pcb (2026-08-25)

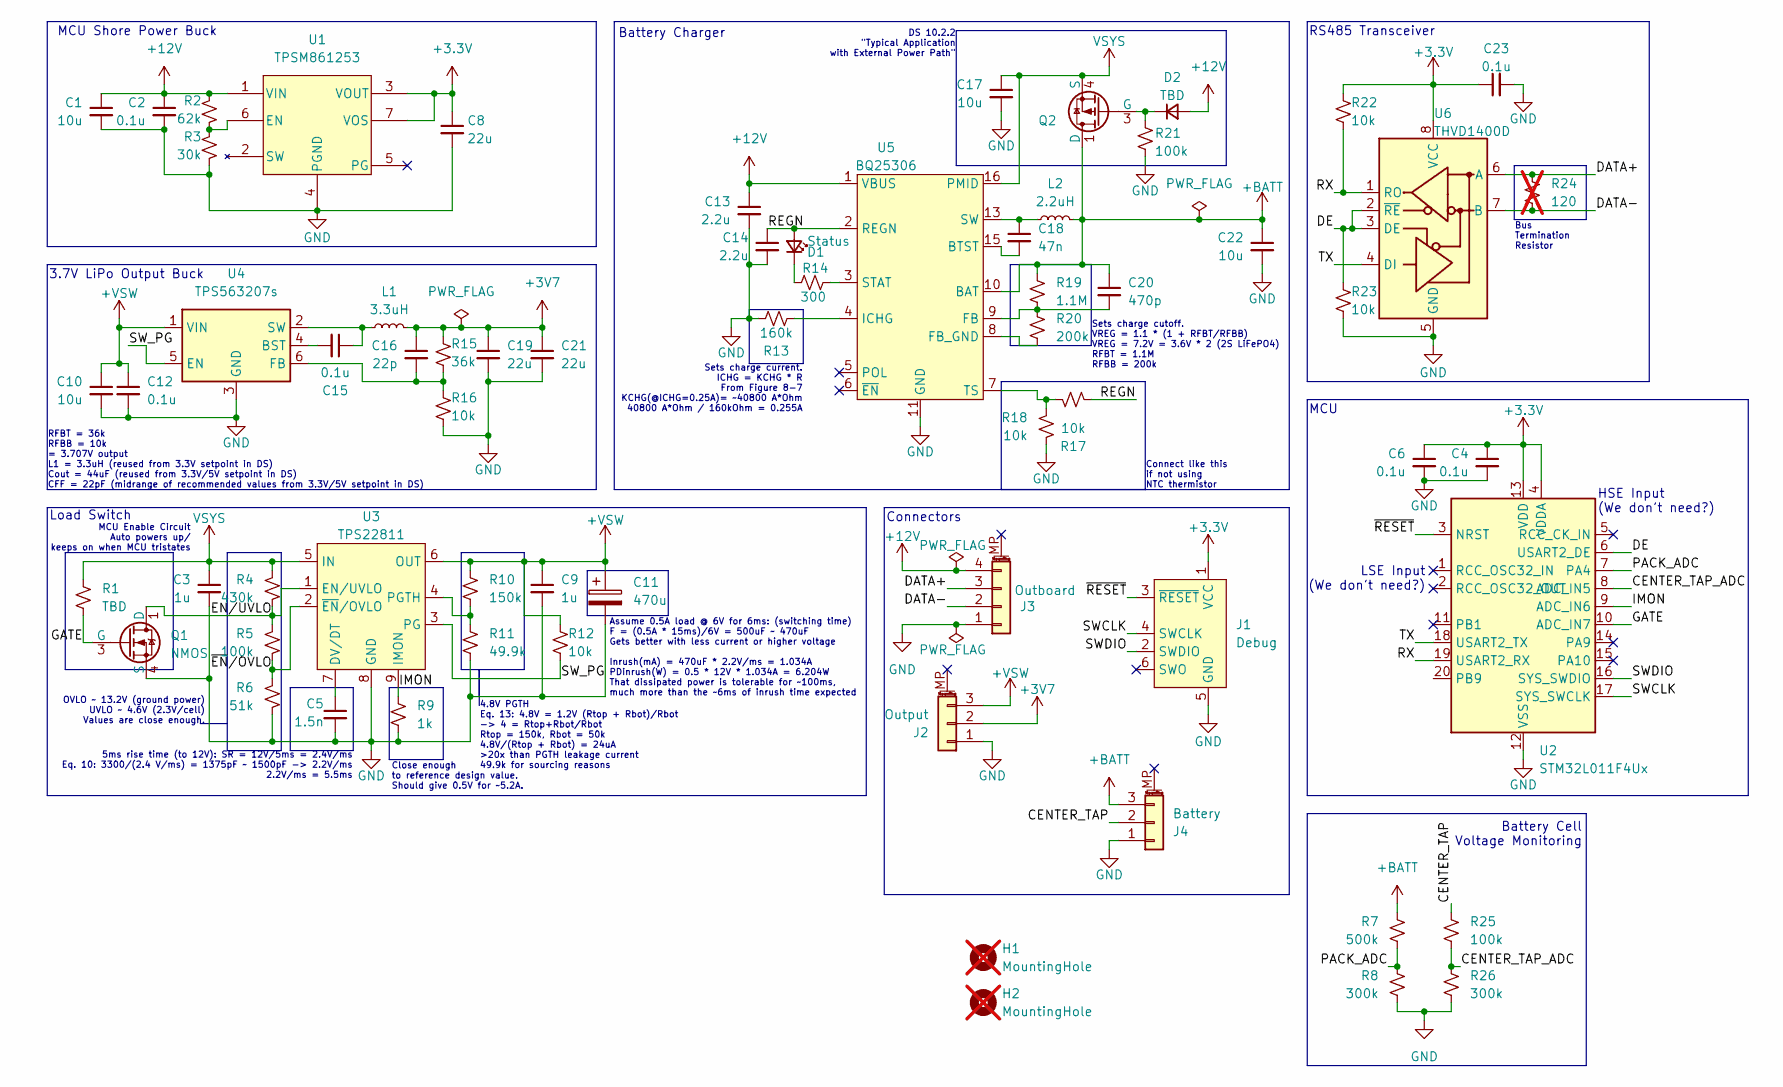
[picture p26: schematic helios-bms.kicad_sch]

Parts:
C1, C10, C17, C22: 10u; C_0603_1608Metric
C2, C4, C6, C12, C15, C23: 0.1u; C_0402_1005Metric
C3, C9: 1u; C_0402_1005Metric
C5: 1.5n; C_0402_1005Metric
C8, C19, C21: 22u; C_0603_1608Metric
C11: 470u; CP_Radial_D6.3mm_P2.50mm
C13, C14: 2.2u; C_0402_1005Metric
C16: 22p; C_0402_1005Metric
C18: 47n; C_0402_1005Metric
C20: 470p; C_0402_1005Metric
D1: Status; LED_0402_1005Metric
D2: TBD; D_0402_1005Metric
H1, H2: MountingHole; MountingHole_3.2mm_M3_DIN965; not fitted
J1: Debug; Tag-Connect_TC2030-IDC-NL_2x03_P1.27mm_Vertical
J2: Output; JST_ZE_SM03B-ZESS-TB_1x03-1MP_P1.50mm_Horizontal
J3: Outboard; JST_ZE_SM04B-ZESS-TB_1x04-1MP_P1.50mm_Horizontal
J4: Battery; JST_ZE_SM03B-ZESS-TB_1x03-1MP_P1.50mm_Horizontal
L1: 3.3uH; L_1008_2520Metric
L2: 2.2uH; L_0805_2012Metric
Q1: NMOS; SOT-1220_UDFN6B_TOS-L
Q2: SSM3J332R; SOT-1220_UDFN6B_TOS-L
R1: TBD; R_0402_1005Metric
R2: 62k; R_0402_1005Metric
R3: 30k; R_0402_1005Metric
R4: 430k; R_0402_1005Metric
R5, R21, R25: 100k; R_0402_1005Metric
R6: 51k; R_0402_1005Metric
R7: 500k; R_0402_1005Metric
R8, R26: 300k; R_0402_1005Metric
R9: 1k; R_0402_1005Metric
R10: 150k; R_0402_1005Metric
R11: 49.9k; R_0402_1005Metric
R12, R16, R17, R18, R22, R23: 10k; R_0402_1005Metric
R13: 160k; R_0402_1005Metric
R14: 300; R_0402_1005Metric
R15: 36k; R_0402_1005Metric
R19: 1.1M; R_0402_1005Metric
R20: 200k; R_0402_1005Metric
R24: 120; R_0402_1005Metric; not fitted
U1: TPSM861253; Texas-QFN-FCMOD-7_4x3.3mm
U2: STM32L011F4Ux; ST_UFQFPN-20_3x3mm_P0.5mm
U3: TPS22811
U4: TPS563207s; SOT-563
U5: BQ25306; WQFN-16-1EP_3x3mm_P0.5mm_EP1.68x1.68mm_ThermalVias
U6: THVD1400D; SOT-583-8

Connections:
+3.3V: C4.1, C6.1, C8.1, C23.1, J1.1 (VCC), R22.1, U1.3 (VOUT), U1.7 (VOS), U2.4 (VDDA), U2.13 (VDD), U6.8 (VCC)
+3V7: C16.1, C19.1, C21.1, J2.2, L1.2, R15.1
+12V: C1.1, C2.1, C13.1, D2.2 (A), J3.4, R2.1, U1.1 (VIN), U5.1 (VBUS)
+BATT: C20.1, C22.1, J4.3, L2.2, Q2.1 (D), Q2.2 (D), Q2.5 (D), Q2.6 (D), Q2.7 (D), R7.1, R19.1, U5.10 (BAT)
+VSW: C9.1, C10.1, C11.1, C12.1, J2.3, R10.1, R12.1, U3.6 (OUT), U4.1 (VIN)
/CENTER_TAP: J4.2, R25.1
/CENTER_TAP_ADC: R25.2, R26.1, U2.8 (ADC_IN5)
/DATA+: J3.3, R24.1, U6.6 (A)
/DATA-: J3.2, R24.2, U6.7 (B)
/DE: R23.1, U2.6 (USART2_DE), U6.2 (~RE), U6.3 (DE)
/EN/UVLO: Q1.1 (D), Q1.2 (D), Q1.5 (D), Q1.6 (D), R4.2, R5.1, U3.1 (EN/UVLO)
/GATE: Q1.3 (G), R1.2, U2.10 (ADC_IN7)
/IMON: R9.1, U2.9 (ADC_IN6), U3.9 (IMON)
/PACK_ADC: R7.2, R8.1, U2.7 (PA4)
/REGN: C14.1, D1.2 (A), R17.2, U5.2 (REGN)
/RX: R22.2, U2.19 (USART2_RX), U6.1 (RO)
/SWCLK: J1.4 (SWCLK), U2.17 (SYS_SWCLK)
/SWDIO: J1.2 (SWDIO), U2.16 (SYS_SWDIO)
/SW_PG: R12.2, U3.3 (PG), U4.5 (EN)
/TX: U2.18 (USART2_TX), U6.4 (DI)
/~EN/OVLO: R5.2, R6.1, U3.2 (~EN/OVLO)
/~RESET: J1.3 (~RESET), U2.3 (NRST)
GND: C1.2, C2.2, C3.2, C4.2, C5.2, C6.2, C8.2, C9.2, C10.2, C11.2, C12.2, C13.2, C14.2, C17.2, C19.2, C21.2, C22.2, C23.2, J1.5 (GND), J2.1, J3.1, J4.1, Q1.4 (S), R3.2, R6.2, R8.2, R9.2, R11.2, R13.2, R16.2, R18.2, R21.2, R23.2, R26.2, U1.4 (PGND), U2.12 (VSS), U3.8 (GND), U4.3 (GND), U5.11 (GND), U5.12 (GND), U5.17 (GND), U6.5 (GND)
unnamed: C18.1, L2.1, U5.13 (SW), U5.14 (SW)
unnamed: D1.1 (K), R14.1
unnamed: D2.1 (K), Q2.3 (G), R21.1
unnamed: R2.2, R3.1, U1.6 (EN)
unnamed: C5.1, U3.7 (DV/DT)
unnamed: R10.2, R11.1, U3.4 (PGTH)
unnamed: C15.2, U4.4 (BST)
unnamed: C16.2, R15.2, R16.1, U4.6 (FB)
unnamed: C15.1, L1.1, U4.2 (SW)
unnamed: C18.2, U5.15 (BTST)
unnamed: C20.2, R19.2, R20.1, U5.9 (FB)
unnamed: R20.2, U5.8 (FB_GND)
unnamed: R13.1, U5.4 (ICHG)
unnamed: R14.2, U5.3 (STAT)
unnamed: R17.1, R18.1, U5.7 (TS)
VSYS: C3.1, C17.1, Q2.4 (S), Q2.8 (S), R1.1, R4.1, U3.5 (IN), U5.16 (PMID)

Notes on the sheet:
3.7V LiPo Output Buck
LSE Input (We don't need?)
MCU Shore Power Buck
Load Switch
4.8V PGTH Eq. 13: 4.8V = 1.2V (Rtop + Rbot)/Rbot -> 4 = Rtop+Rbot/Rbot Rtop = 150k, Rbot = 50k 4.8V/(Rtop + Rbot) = 24uA >20x than PGTH leakage current 49.9k for sourcing reasons
OVLO ~ 13.2V (ground power) UVLO ~ 4.6V (2.3V/cell) Values are close enough.
DS 10.2.2 "Typical Application with External Power Path"
Sets charge cutoff. VREG = 1.1 * (1 + RFBT/RFBB) VREG = 7.2V = 3.6V * 2 (2S LiFePO4) RFBT = 1.1M RFBB = 200k
RFBT = 36k RFBB = 10k = 3.707V output L1 = 3.3uH (reused from 3.3V setpoint in DS) Cout = 44uF (reused from 3.3V/5V setpoint in DS) CFF = 22pF (midrange of recommended values from 3.3V/5V setpoint in DS)
Close enough to reference design value. Should give 0.5V for ~5.2A.
Sets charge current. ICHG = KCHG * R From Figure 8-7 KCHG(@ICHG=0.25A)= ~40800 A*Ohm 40800 A*Ohm / 160kOhm = 0.255A
MCU Enable Circuit Auto powers up/ keeps on when MCU tristates
Connect like this if not using NTC thermistor
HSE Input (We don't need?)
RS485 Transceiver
MCU
Bus Termination Resistor
5ms rise time (to 12V): SR = 12V/5ms = 2.4V/ms Eq. 10: 3300/(2.4 V/ms) = 1375pF ~ 1500pF -> 2.2V/ms 2.2V/ms = 5.5ms
Battery Cell Voltage Monitoring
Assume 0.5A load @ 6V for 6ms: (switching time) F = (0.5A * 15ms)/6V = 500uF ~ 470uF Gets better with less current or higher voltage Inrush(mA) = 470uF * 2.2V/ms = 1.034A PDinrush(W) = 0.5 * 12V * 1.034A = 6.204W That dissipated power is tolerable for ~100ms, much more than the ~6ms of inrush time 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
Battery Charger
Connectors

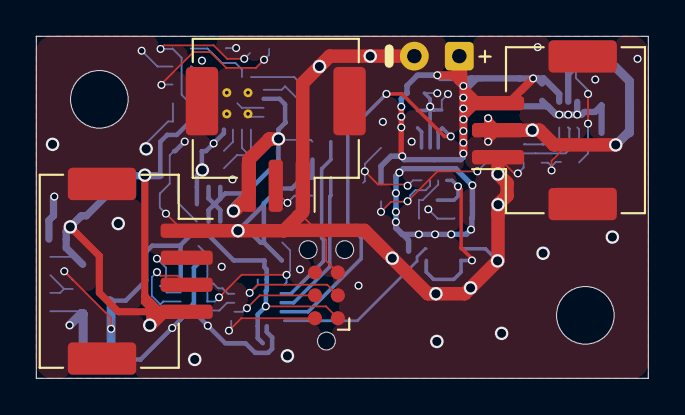
[picture p27: board helios-bms.kicad_pcb from above]

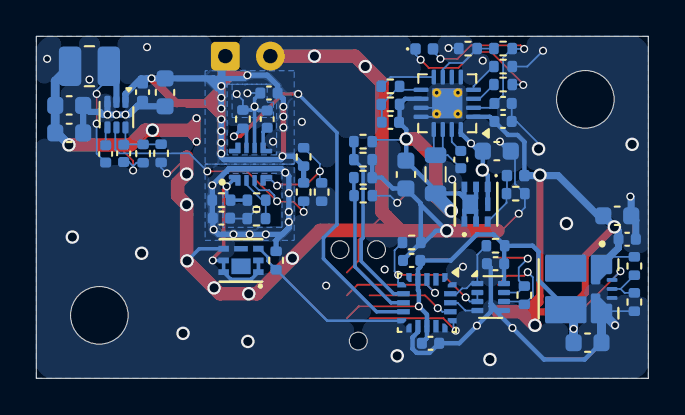
[picture p28: board helios-bms.kicad_pcb from below]

Board: 4 copper layers, 34.0 x 19.0 mm, 66 parts (59 on the bottom side), 39 nets.
