Helios-Rocket/power-management/(commit log)

2026-08-07 some component selection
    [RTE0016C.stp, RXP0008A.stp, TPS22811LRPWR.STEP, main-board.kicad_pcb, main-board.kicad_sch]
2026-08-14 bms board schematic capture done?
    [RTE0016C.stp, RXP0008A.stp, TPS22811LRPWR.STEP, TPSM861253RDXR.step, helios-bms.kicad_pcb, helios-bms.kicad_sch, main-board.kicad_pcb, main-board.kicad_sch]
2026-08-18 components selected
    [UDFN6B.STEP, helios-bms.kicad_sch]
2026-08-20 fixed ERC errors
    [helios-bms.kicad_pcb, helios-bms.kicad_sch]
2026-08-21 routed 2layer 2oz, gonna change to 4layer 1oz
    [SM03B-ZESS-TB.STEP, SM04B-ZESS-TB.STEP, UFQFPN20_3x3x0p6.step, helios-bms.kicad_pcb, helios-bms.kicad_sch]
2026-08-25 rerouted for 4 layers
    [helios-bms.kicad_pcb, helios-bms.kicad_sch]
2026-09-29 pre DR
    [SM03B-ZESS-TB.STEP, SM04B-ZESS-TB.STEP, TPS22811LRPWR.STEP, TPSM861253RDXR.step, UDFN6B.STEP, UFQFPN20_3x3x0p6.step, helios-bms-life.kicad_pcb, helios-bms-life.kicad_sch]
2026-09-29 post DR LiFe board partially done, need to clean up the BoM on digikey BADDD
    [SM02B-ZESS-TB.STEP, helios-bms-life.kicad_pcb, helios-bms-life.kicad_sch]
2026-09-29 LiFe board done
    [helios-bms-life.kicad_pcb, helios-bms-life.kicad_sch]
2026-09-29 update BoM
    [helios-bms-life.kicad_pcb, helios-bms-life.kicad_sch, helios-bms-lipo.kicad_pcb, helios-bms-lipo.kicad_sch]
2026-09-29 oops screwed up power net labels
    [helios-bms-life.kicad_sch]
2026-09-29 satellite boards done
    [S2B-PH-SM4-TB.STEP, helios-bms-life.kicad_sch, helios-bms-life.step, helios-bms-lipo.kicad_pcb, helios-bms-lipo.kicad_sch, helios-bms-lipo.step]
2026-10-05 BMS satellite boards ready, controller needs routing
    [helios-bms-life.kicad_pcb, helios-bms-life.kicad_sch, load_sw.kicad_sch, rs485-driver.kicad_sch, umbilical-controller.kicad_pcb, umbilical-controller.kicad_sch]
2026-10-05 umbilical controller done
    [2601-1102.igs, ESP32-C6-MINI-1.STEP, mtj-889x1-model.step, umbilical-controller.kicad_pcb, umbilical-controller.kicad_sch]
2026-10-07 JLC order ready
    [helios-bms-life.kicad_pcb, helios-bms-life.kicad_sch, helios-bms-lipo.kicad_sch, load_sw.kicad_sch, umbilical-controller.kicad_pcb, vehicle-connector.kicad_pcb, vehicle-connector.kicad_sch]
