Helios-Rocket/power-management/(notices)

Notices in the files:
common/2601-1102.igs:
Data from Parasolid IGES Translator 28.1.247, Copyright(c) 2006 Siemens S 1
PLM Software. All Rights Reserved. S 2
